RFSAT/PicoRTK/hardware/case/README.md

# PicoRTK case (Pico 2 W + Waveshare LG290P)

Two printed parts, `picortk_case_base.stl` and `picortk_case_lid.stl`, plus two optional ones: `picortk_usbc_cover.stl` and the test piece `picortk_ko_test.stl`. All are generated from the parametric `picortk_case.scad` (OpenSCAD 2021 or later).

**Outside size:** 56 × 44 × 19.5 mm (base 17.5 mm high, lid 2 mm).

## Layout (mm, floor top = 0)

| Item | Height |
|---|---|
| LG290P board, component side down | 7 mm printed columns; its battery reaches the floor |
| Gap between the boards | 3.5 mm (the foam; the Pico's USB end rests on it) |
| Pico 2 W | 11.5 mm printed columns, at its two antenna-end holes, so the board lies flat |
| Pico PCB (1 mm) to the underside of the lid | 3 mm, as measured on the printed case; the micro-USB socket just touches the lid |

- Both boards are flush at the Pico's USB end and centred across.
- The GNSS board is 3.5 mm from the front wall (UART cable plug, USB-C) and 3.5 mm from the back wall, so the boards and the micro-USB slot are centred on the case.
- At the SMA, the back wall steps in to the connector's flange over 12 mm, so about 6 mm of thread still sticks out.

## Openings

| Opening | Where | How it's made |
|---|---|---|
| Pico micro-USB | left wall | U-slot 10 mm wide, 4 mm deep from the top of the base wall, continued through the lid edge (the plug is taller than the space above the Pico) |
| LG290P USB-C | front wall | 10.5 × 6 mm opening, centred on the socket, **closed by a break-out panel** (see below); fits slim USB-C plugs (set `usbc_w = 12.5`, `usbc_h = 7` for bulky ones) |
| SMA | back wall | U-slot; a tongue on the lid closes it over the connector, reaching 0.5 mm lower than the slot centre (`sma_tab_drop`); about 6 mm of thread sticks out. The lid follows the base outline, including the step at the SMA |
| BOOTSEL | lid | 3.2 mm hole: press with a toothpick |
| RST | floor | 3.2 mm hole: press with a straightened paperclip (the button faces down) |
| Pico LED | lid | 2 mm light window |

## LG290P USB-C break-out panel

The receiver's own USB-C is only needed for firmware updates and diagnostics with QGNSS, so the case comes with that opening closed.

- **How the panel is held:** it sits in the opening with a 0.5 mm slot all round. On the outside face it is held by a thin 0.4 mm web along its bottom edge and by a small tab at the middle of each side. The top edge is free.
- **To open it:** put a small flat screwdriver in the notch at the top edge from outside and lever outwards. The panel pivots on its bottom edge, the tabs snap, and it comes away outwards, not into the case. Trim the remains of the web and tabs with a knife or file.
- **To close it again:** press in `picortk_usbc_cover.stl`. It is a plug with a thin outer flange, two crush ribs and a pull tab, printed flange down.
- **Plain opening instead:** set `usbc_mode = "open"`.

**Print `picortk_ko_test.stl` first.** It is a 2 mm wall with the same panel, printed upright like the case wall, and takes a few minutes.

- If it is too hard to break, reduce `ko_tab_h` (1.2 mm).
- If it falls out by itself or the web is missing, increase `ko_web` from 0.4 to 0.6 mm. A 0.4 mm web is one extrusion line with a 0.4 mm nozzle: the slicer must keep thin walls (PrusaSlicer/Orca/Cura with Arachne do by default).
- If the cover is too tight or too loose, adjust `cover_fit` (0.15 mm per side).

## Board columns

The base has six printed columns, each with a 1.7 mm pilot hole for an M2 thread-forming screw:

- four 7 mm columns under the GNSS board's corner holes: 4.5 mm across, except the one on the USB-C side at the end away from the micro-USB, which is 4.0 mm (`col_d_gnss_tight`) because on the printed revision 3 it touched components on the board;
- two 11.5 mm columns (4.2 mm across) under the Pico's antenna-end holes (10 mm up to revision 7, which tilted the Pico).

To use M2 heat-set inserts instead, set `col_pilot = 3.2`.

## Hardware

| Part | Qty |
|---|---|
| M2 × 5 thread-forming screw for plastic (boards onto the columns) | 6 |
| M2 × 5 countersunk thread-forming screw (lid) | 4 |

The LG290P USB-C cover, if used, needs no hardware.

## Printing

- **Base:** print floor down.
- **Lid:** printed top face down (the STL is already oriented).
- **Settings:** 0.2 mm layers, 3 walls, PETG or PLA. No supports needed: the back-left lid boss hangs from the wall above the GNSS board on a 45° cone.

## Assembly

1. Put the boards on, already taped together. The SMA drops into its U-slot and the micro-USB into its slot.
2. Screw the GNSS board down at its four corners; they are clear of the Pico. Then screw the Pico at its two antenna-end holes.
3. Plug in the UART cable, fit the lid, and screw it down.

## Check against your boards before printing

All of these are parameters at the top of the `.scad` file.

- **Board heights:** the column heights (7 and 11.5 mm) give a 3.5 mm gap between the boards with a 1.0 mm GNSS board (`gnss_t`), and put the Pico 3 mm under the lid, as measured on the printed revision 3. If `pico_stand` changes, change `above_pico` by the opposite amount to keep the case height. OpenSCAD prints the resulting gap.
- **Button positions:**
  - Pico BOOTSEL: x = 12.0, y = 7.2 from the USB end and pin-1 edge.
  - LG290P RST: x = 4.6, y = 3.6 from the USB end and UART edge. It must not be covered by the battery.
  - Both were measured from Waveshare and Raspberry Pi drawings.
- **SMA flange:** at the SMA the wall steps in to 1.9 mm beyond the GNSS board edge (`sma_flange`), for the connector's square flange.
- **Wires over the Pico:** 3 mm of space suits wires soldered to the pads. Dupont sockets on upward pins need `above_pico` of about 13.
