RFSAT/PicoRTK/hardware/case/picortk_ko_test.stl

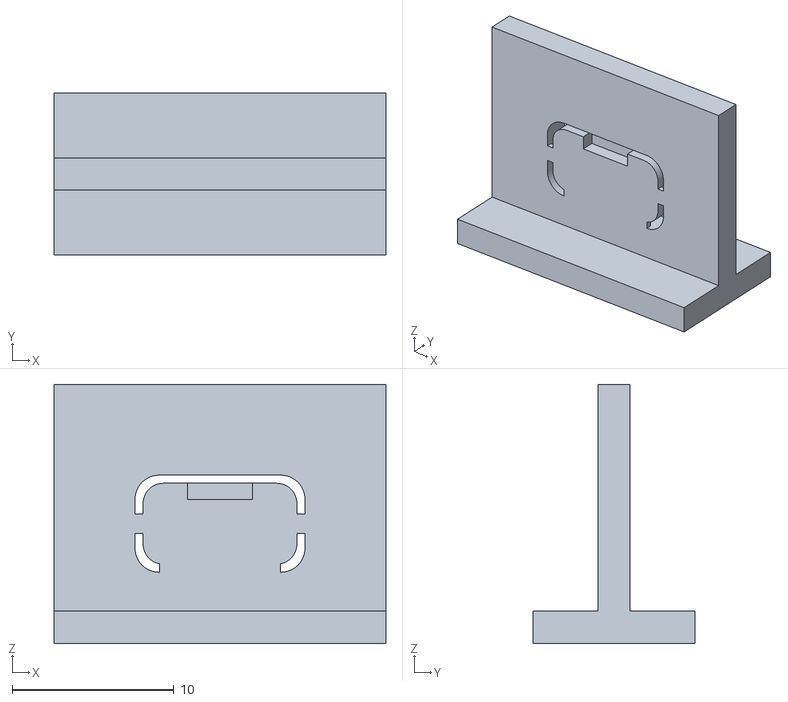
[picture p1: CAD file, 2026-11-09]
hardware/case/picortk_ko_test.stl
20.5 x 10.0 x 16.0
