RFSAT/PicoRTK/hardware/case/picortk_case_base.stl

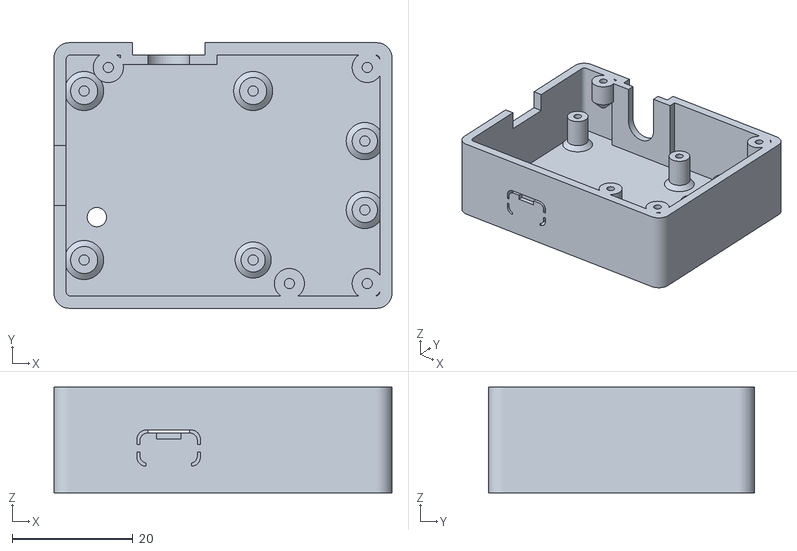
[picture p2: CAD file, 2026-11-09]
hardware/case/picortk_case_base.stl
56.0 x 44.0 x 17.5
