RFSAT/PicoRTK/hardware/case/picortk_case_lid.stl

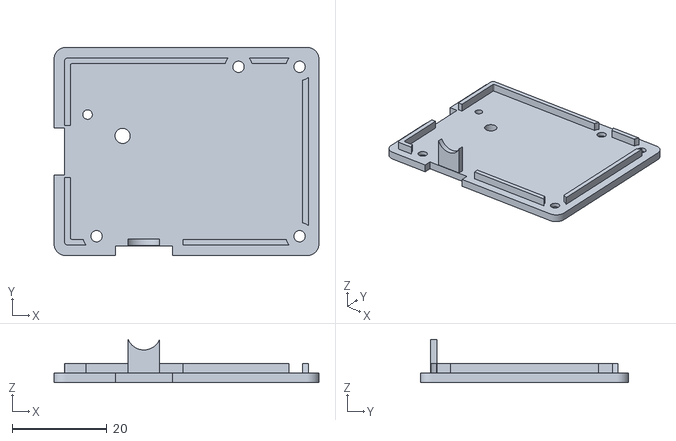
[picture p3: CAD file, 2026-11-09]
hardware/case/picortk_case_lid.stl
56.0 x 44.0 x 9.12
