RFSAT/PicoRTK/hardware/case/picortk_usbc_cover.stl

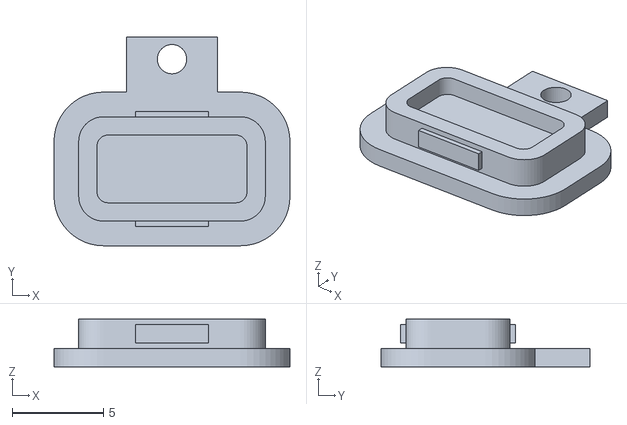
[picture p4: CAD file, 2026-11-09]
hardware/case/picortk_usbc_cover.stl
12.9 x 11.4 x 2.60
