RFSAT/PicoRTK/(commit log)

2026-10-22 Defaults: Metrica MSM_NEAR before MSM_VRS (6 mm reference with EOS Arrow Gold)
    Claude-Session: https://claude.ai/code/session_01957FYQcY1yfCUAseQTkPpm
2026-10-22 CI: install a pinned arduino-cli with setup-arduino-cli instead of install.sh
    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
2026-10-22 README: wiring for the ZJI RF LG290P board
    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
2026-10-23 Restart: stop Bluetooth/Wi-Fi and power the CYW43 off before the reset; start-up log on USB
    A software restart (Save, Restart button) left the radio chip warm and the board
    needed a power cycle. The radio is now shut down and powered off via WL_ON first.
    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
    [PicoRTK.ino, outputs.cpp, outputs.h, util.h, web.cpp]
2026-10-24 Bench position: send a configured GGA to VRS/nearest casters until the receiver has a fix (NTP time)
    Metrica MSM_NEAR answered 200 OK but streamed nothing without a rover position.
    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
    [config.h, net.cpp, nmea.cpp, nmea.h, ntrip.cpp]
2026-10-24 Web page: full width, sources and Wi-Fi as one-row tables, single-line status; NTRIP diagnostics
    - Status shows bytes on the current stream, GGA sent count and the last GGA
    - Event log records each GGA until data arrives, the first data byte, and chunked replies
    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
2026-10-24 Restart hardening: watchdog-guarded restart, radio cut first; hardware watchdog fed by core 1 while core 0 is alive; last reset reason on the page
    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
    [PicoRTK.ino, web.cpp]
2026-10-24 NMEA tab (live output monitor, per-type counts, type filter for Bluetooth/TCP) and safe shutdown
    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
2026-10-24 Wi-Fi: disable radio power-save (missed incoming connections); reconnect when joined without an IP
    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
    [net.cpp]
2026-10-24 Web page: NMEA types as toggle buttons; help tips on fields, columns and status lines
    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
2026-10-24 NMEA application profiles, full LG290P message catalogue, receiver configuration from the web page; Home tiles sized to content
    - Nine profiles (survey/GIS, static monitoring, agriculture, road vehicles, robots/drones, marine, timing, minimal, research)
    - All 20 switchable LG290P output messages with help texts; fix rate 1-10 Hz read from the receiver
    - Apply to receiver: PQTMCFGMSGRATE on/off, PQTMCFGFIXRATE, PQTMCFGODO, PQTMSAVEPAR, PQTMSRR, with reply check
    - Firmware keeps the receiver's command replies for the page (/api/nmea replies), ids up to 19 chars
    - Bandwidth estimate per selection; full last GGA moved under Correction events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
    [nmea.cpp, nmea.h, receiver.cpp, shared.h, web.cpp]
2026-10-24 Web page: compact NMEA tab (one section, small profile buttons with details in the tip, inline group labels, one control row)
    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
2026-10-24 Web page: profile message lists wrap onto free lines instead of being cut
    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
2026-11-05 README: Waveshare LG290P wiring on UART3, compact back-to-back assembly
    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
2026-11-05 README: pluggable prototype assembly on a carrier board
    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
2026-11-05 CI: cache the Pico core and retry downloads (GitHub release 504s)
    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
2026-11-05 README: cable-and-foam-tape prototype assembly (no carrier), SMA through the case wall
    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
2026-11-05 README: the Waveshare board has its own SMA socket
    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
2026-11-05 README: SH1.0 cable wire colours
    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
2026-11-05 Case: parametric OpenSCAD model and STLs for the Pico 2 W + Waveshare LG290P stack
    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
    [picortk_case.scad, picortk_case_base.stl, picortk_case_lid.stl]
2026-11-05 Firmware: optional private build defaults (git-ignored header from a settings file), Restore defaults button
    - tools/make_defaults.py compiles a downloaded settings file into firmware/PicoRTK/defaults_local.h (git-ignored)
    - configLoad applies it after the public defaults; saved settings still take precedence
    - System -> Restore defaults (/api/factory) deletes the saved settings and restarts
    - Public defaults: EUREF on euref-ip.be/PAT000GRC0, NTRIP 2 for Metrica and EUREF
    - Status reports privateDefaults; the header line shows (private build)
    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
2026-11-05 Case: printed board columns (7 mm GNSS, 10 mm Pico) instead of loose standoffs
    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
    [picortk_case.scad, picortk_case_base.stl, picortk_case_lid.stl]
2026-11-05 Case: 4 mm between the Pico and the lid (19 mm high), micro-USB slot through the lid edge, M2x5 lid screws
    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
    [picortk_case.scad, picortk_case_base.stl, picortk_case_lid.stl]
2026-11-05 Case: 0.5 mm extra margin above the Pico (4.5 mm to the lid, 19.5 mm high)
    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
    [picortk_case.scad, picortk_case_base.stl, picortk_case_lid.stl]
2026-11-05 Case: smaller USB-C opening (10.5 x 6 mm, slim plugs)
    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
    [picortk_case.scad, picortk_case_base.stl]
2026-11-05 Case: fix the micro-USB slot position (used x instead of y) and centre the boards across the case
    - back gap 4 mm like the front, so the Pico (and the slot) sit on the case centre line
    - SMA bay: the back wall steps in to the SMA flange so the thread length is unchanged
    - the back-left lid boss stands on the floor now (no corbel)
    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
    [picortk_case.scad, picortk_case_base.stl, picortk_case_lid.stl]
2026-11-05 Case: 3.5 mm board-to-wall gap front and back (56 x 44 mm); back-left lid boss hangs above the GNSS board again (it overlapped the board edge)
    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
    [picortk_case.scad, picortk_case_base.stl, picortk_case_lid.stl]
2026-11-05 Case README: remove a repeated sentence
    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
2026-11-05 Correction modes: RTK via NTRIP or Galileo HAS, switched from the Home page
    - corrections.mode (rtk | has) and corrections.galileoHas (HAS fallback in RTK mode) in the settings
    - HAS mode: NTRIP off, inbound RTCM from apps off; receiver set with PQTMCFGPPP,W,2,1,120,0.10,0.15
    - /api/mode switches at run time (saved, no restart); PQTMCFGPPP sent at start-up and on each change
    - Home: RTK / Galileo HAS switch with a status note; fix shows Galileo HAS when GGA station is 9002
    - NMEA type filter accepted only ids up to 10 characters: now up to 19 (PQTMGEOFENCESTATUS)
    Claude-Session: https://claude.ai/code/session_01957FYQcY1yfCUAseQTkPpm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
    [PicoRTK.ino, config.h, ntrip.cpp, ntrip.h, outputs.cpp, web.cpp]
2026-11-05 Home: estimated accuracy and Galileo HAS status; Receiver tab: command replies; long PQTM sentences no longer dropped
    - NMEA_MAX 128 -> 255: PQTMPPPNAV, PQTMNAV and PQTMPVT (about 200-230 characters) were counted as bad and dropped
    - receiver: parse GST, PQTMEPE (v2) and PQTMPPPNAV (v1); /api/status reports gstH/gstV, epeH/epeV and ppp {sol,h,v,diffId,age,sats}
    - start-up enables GST, PQTMEPE and PQTMPPPNAV on the Pico's UART (not saved in the receiver)
    - Position tile: Accuracy (estimated) and Galileo HAS rows; fix shows HAS converging / converged
    - Receiver tab: Receiver replies panel (from the reply log), refreshed after Send
    - unit tests for the three parsers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
    [PicoRTK.ino, nmea.cpp, nmea.h, receiver.cpp, shared.h, web.cpp]
2026-11-05 Methods panel, reference point, actual error, accuracy trace and static-demo SBAS hold
    The LG290P computes one solution at a time, so the Home page now lists the
    methods over time (RTK, Galileo HAS, SBAS, GNSS only): the running one and the
    last figures of the stopped ones, with the receiver's estimate and the actual
    error against a reference point recorded from an RTK fix. A 30-minute trace
    shows estimate and error per method. Optional static-demo hold: while HAS
    converges and is worse than the last SBAS fix, Bluetooth/TCP get that SBAS
    position (GGA/RMC/GLL/GNS), clearly flagged on the page.
    Claude-Session: https://claude.ai/code/ses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
    [config.h, methods.cpp, methods.h, receiver.cpp, shared.h, web.cpp]
2026-11-05 Methods on their own tab instead of the Home page; taller trace
    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
2026-11-05 History in flash with CSV download: one record every 10 s, kept across restarts
    Core 1 queues a record (UTC date/time, method, estimate, actual error,
    position, satellites, HDOP, hold) every 10 s; core 0 appends to LittleFS every
    5 min and at shutdown/restart, in two rotating 384 KB files (about 39 h).
    Methods tab: record count, time span, Download CSV, Clear history.
    Also loads the reference point after the settings at start-up.
    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
    [PicoRTK.ino, history.cpp, history.h, methods.cpp, methods.h, receiver.cpp, shared.h]
2026-11-05 Restart recorder, permanent: checkpoints and crash address kept across a restart
    Replaces the temporary diagnostic printing with a quiet recorder: the System tab
    (Last restart) and /api/status (previousRun) say whether the previous run ended
    normally, crashed (with core, address and the step each core was at) or hung and
    was restarted by the watchdog. Restart/Shut down from the page count as normal.
    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
    [PicoRTK.ino, diag.cpp, diag.h, web.cpp]
2026-11-06 Case: lid STL turned over instead of mirrored
    The print orientation used mirror([0,0,1]), which made the printed lid the mirror
    image of the design: turned over onto the base, its lip, SMA tab, bosses and
    micro-USB notch landed on the wrong sides. It is now rotated 180 degrees about X;
    checked: the printed lid turned back over matches the designed lid exactly and
    does not overlap the base.
    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
    [picortk_case.scad, picortk_case_lid.stl]
2026-11-06 Methods: report live/stale corrections, their age and base, speed and movement; remove the hold
    Each method now shows where its corrections come from and how old they are:
    RTK/DGNSS live (RTCM in the last 5 s) or stale (none arriving, the receiver
    still using the last data), HAS E6 correction age, EGNOS PRN. Home says
    'RTK fixed (stale corrections)'. Speed and stationary/moving (hysteresis) from
    RMC. History format 2 (72-byte records) adds corrections, age, base/PRN, speed,
    moving. The static-demo hold is removed: positions go to the apps exactly as
    the receiver computes them.
    Claude-Session: https://claude.ai/code/session_01957FYQcY1y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
    [config.h, history.cpp, history.h, methods.cpp, methods.h, receiver.cpp, shared.h]
2026-11-06 Chart from the stored history: survives restarts, 30 min / 2 h / 6 h / 24 h, UTC clock axis
    /api/trace now reads the newest history records backwards from flash (thinned to
    at most 720 points) on UTC time, so the previous session shows straight after a
    restart or firmware update. Gaps (off, restarting) are hatched and break the
    lines. Falls back to this start-up's samples until the receiver gives a date.
    History: records still on their way from core 1 are written too at shutdown,
    restart and download.
    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
2026-11-06 Events kept in flash by session, newest first, scroll position kept
    Correction events plus start-up, Restart and Shut down go to /events.log with
    session number, uptime and UTC; written every 30 s and at Restart/Shut down.
    All events of the current session are kept; at 64 KB the oldest earlier
    sessions are trimmed first (evtrim, unit-tested), and only if the current
    session alone fills the log are its oldest events removed, with a count.
    The Home page reloads the list only on a new event and keeps the reader's
    scroll position.
    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
    [PicoRTK.ino, eventlog.cpp, eventlog.h, evtrim.cpp, evtrim.h, ntrip.cpp, web.cpp]
2026-11-09 Case: break-out panel over the LG290P USB-C, optional press-in cover and test piece
    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
    [picortk_case.scad, picortk_case_base.stl, picortk_case_lid.stl, picortk_ko_test.stl, picortk_usbc_cover.stl]
2026-11-09 Case: micro-USB slot 2 mm narrower (10 mm) and 3 mm shallower
    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
    [picortk_case.scad, picortk_case_base.stl, picortk_case_lid.stl]
2026-11-09 Case: lid follows the base outline at the SMA step; lid tongue reaches 1 mm lower onto the SMA
    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
    [picortk_case.scad, picortk_case_lid.stl]
2026-11-09 Case: lid tongue 0.5 mm lower onto the SMA (was 1.0)
    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
    [picortk_case.scad, picortk_case_lid.stl]
2026-11-09 Case preview: draw the Pico tilted, USB end 1.85 mm up, micro-USB just touching the lid (as on the print); printed parts unchanged
    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
    [picortk_case.scad]
2026-11-09 Case preview: Pico PCB 3 mm below the lid at its USB end (lift 1.5 mm), micro-USB socket 2.95 mm tall touching the lid, as measured on the print
    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
    [picortk_case.scad]
2026-11-09 Case: Pico columns 11.5 mm (was 10) so the Pico lies flat 3 mm under the lid, as measured; same case height, lid unchanged
    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
    [picortk_case.scad, picortk_case_base.stl, picortk_case_lid.stl]
2026-11-09 Case: keep the revision 7 lid STL file (same geometry)
    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
    [picortk_case_lid.stl]
2026-11-09 Case: GNSS column at (30.5, USB-C side) 4.0 mm across (was 4.5), clear of the board's components
    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
    [picortk_case.scad, picortk_case_base.stl]
2026-11-09 Case: USB-C break-out web and tabs 0.4 mm (was 0.6)
    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
    [picortk_case.scad, picortk_case_base.stl, picortk_ko_test.stl]
2026-11-10 Method ladder from PostcardRTK, advice only by default
    Runs on every GGA and reports on the Home page and in the event log (state changes only). It pauses
    NTRIP only with corrections.autoPause = true; the $PRFSM status sentence only with statusSentence = true.
    Defaults leave NTRIP, outputs and accuracy unchanged. +2.7 KB flash, +0.6 KB RAM. Ladder tests added.
    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
    [PicoRTK.ino, config.h, ladder.cpp, ladder.h, ntrip.cpp, ntrip.h, outputs.cpp]
